MarinStevic/PassVault/README.md

PassVault

Uređaj dizajniran u sklopu diplomskog rada: https://dabar.srce.hr/islandora/object/etfos%3A3328
