MarinStevic/PassVault/BOM/PassVault.xlsx

Qty | Value | Device | Package | Parts | Reference Partno.
1 | 470R | R-US_R0201 | R0201 | R2 | RC0201FR-07470RL
2 | 4.7k | R-US_R0201 | R0201 | R1, R5 | RC0201FR-074K7L
2 | 16p | C-EUC0201 | C0201 | C15, C21 | CC0201JRNPO9BN160
1 | 2.4p | C-EUC0201 | C0201 | C20 | GRM0335C1E2R4CA01D
1 | 3p | C-EUC0201 | C0201 | C18 | GRM0335C1H3R0BA01D
1 | 100p | C-EUC0201 | C0201 | C12 | CC0201JRNPO9BN101
1 | 1n | C-EUC0201 | C0201 | C1 | GRM033R61E102KA01D
8 | 100n | C-EUC0201 | C0201 | C5, C6, C8, C9, C10, C14, C17, C19 | CC0201KRX5R6BB104
1 | 100n | C-EUC0402 | C0402 | C2 | GRM155R71H104ME14D
3 | 1u | C-EUC0201 | C0201 | C7, C11, C13 | CL03A105MQ3CSNC
2 | 1u 10V | C-EUC0402 | C0402 | C3, C4 | CL03A105MP3NSNC
1 | 10u | C-EUC0402 | C0402 | C16 | GRJ155R60J106ME11D
1 | 2nH | L-USL0201 | L0201 | L1 | LQP03TG2N0B02D
1 | 2.2nH | L-USL0201 | L0201 | L2 | SDCL0603Q2N2BT02B03
1 | USB_A_SMT_MALE | USB_A_SMT_MALE | USB-A-SMT-MALE | J2 | U217-041N-4BV81
1 | MOMENTARY-SWITCH-SPST-SMD-12MM | MOMENTARY-SWITCH-SPST-SMD-12MM | TACTILE_SWITCH_SMD_12MM | BOOT | K2-1103SP-E4SW-04
1 | WS2812B3535 | WS2812B3535 | LED3535 | LED1 | WS2812B-Mini
1 | LESD8D3.3CAT5G | LESD8D3.3CAT5G | LESD8D3.3CAT5G | D1 | LESD8D3.3CAT5G
1 | ME6210A33M3GME6210A33M3G | ME6210A33M3GME6210A33M3G | SOT95P280X110-3N | U1 | ME6210A33M3G
1 | W25Q16JVSSIQ | W25Q16JVSSIQ | SOIC127P790X216-8N | U2 | W25Q32JVSSIQ
1 | ESP32-S2QFN54 | ESP32-S2QFN54 | QFN40P700X700X90-57T400N | U3 | ESP32-S2
1 | ABM8W-40.0000MHZ-4-B1U-T3 | ABM8W-40.0000MHZ-4-B1U-T3 | OSCSC320X250X100N | Y1 | CF4040M00012T8188059
