MarinStevic/PassVault/3D Model/PassVault.step

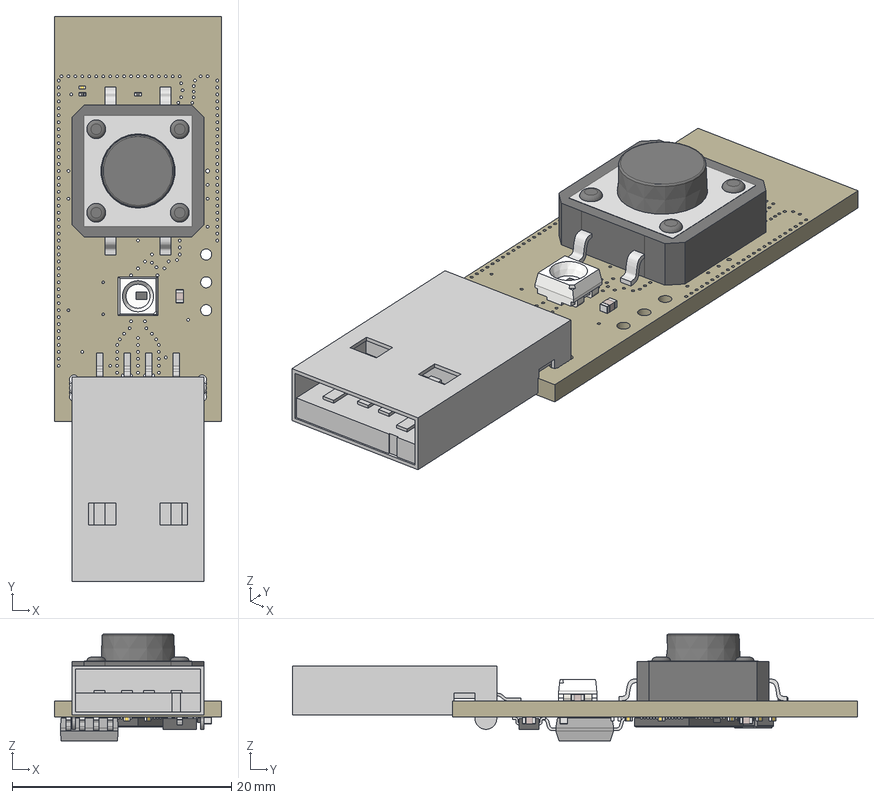
[picture p1: CAD file, 2021-11-04]
3D Model/PassVault.step
15.2 x 51.6 x 9.75 mm
Board
LED3535
QFN40P700X700X90-57T400N
1X03
USB-A-SMT-MALE
TRACE_ANTENNA_2.4GHZ_15.2MM
TACTILE_SWITCH_SMD_12MM
C0201 x 17
C0402 x 4
L0201 x 2
R0201 x 3
OSCSC320X250X100N
LESD8D3.3CAT5G
SOIC127P790X216-8N
SOT95P280X110-3N
