MarinStevic/PassVault/Schematic/PassVault.pdf

# GND100n GND

# GND GND

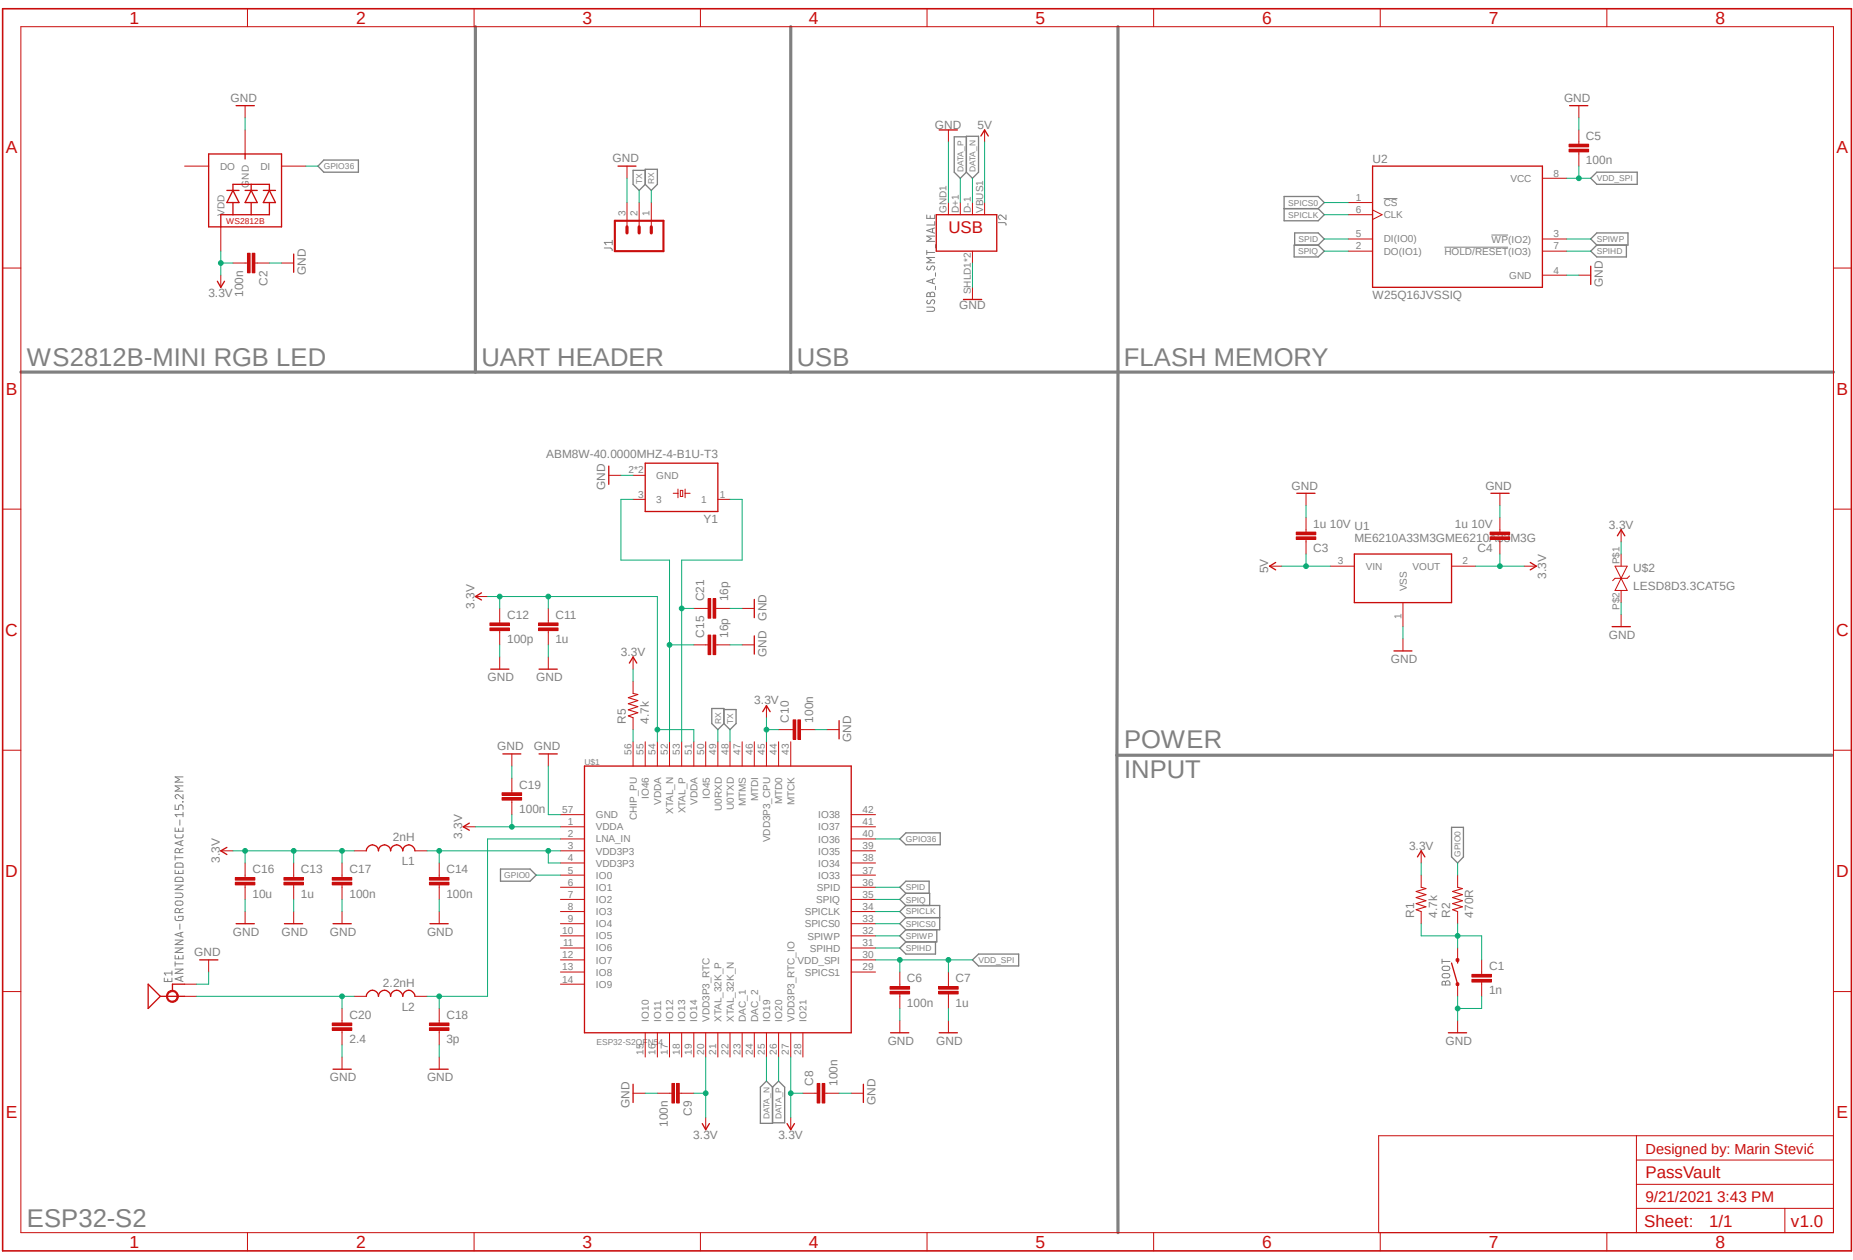
[picture p2: page 1]

WS2812B-MINI RGB LED | GND UART HEADER | GND 5V USB | FLASH MEMORY
