MarinStevic/PassVault/Eagle files/PassVault.brd

## EAGLE design Eagle files/PassVault.brd (2021-11-04)

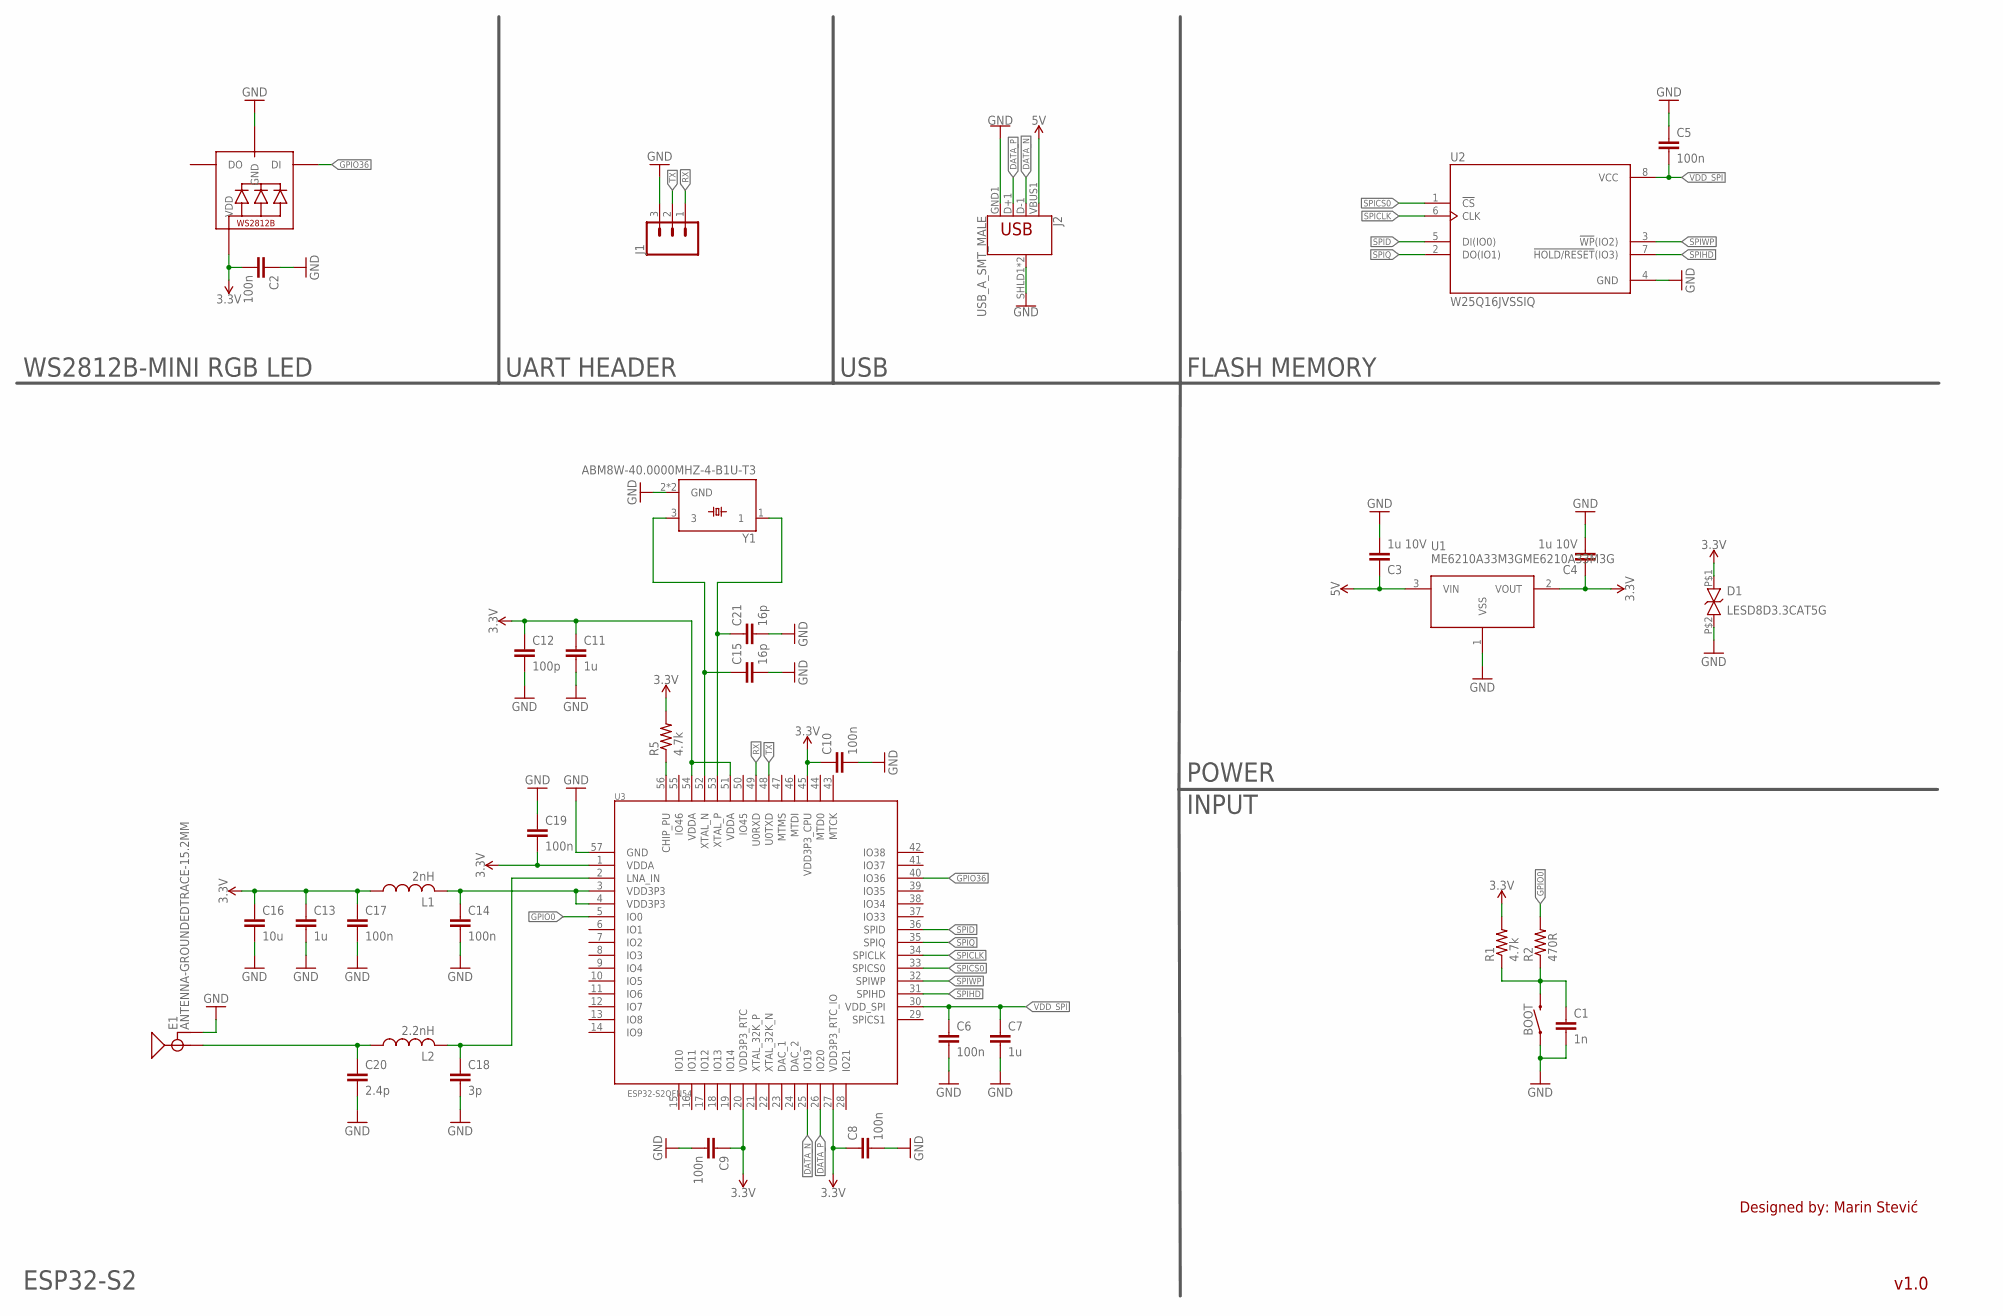
[picture p3: schematic PassVault.sch]

Parts:
BOOT: MOMENTARY-SWITCH-SPST-SMD-12MM; TACTILE_SWITCH_SMD_12MM
C1: 1n; C0201
C2: 100n; C0402
C3, C4: 1u 10V; C0402
C5, C6, C8, C9, C10, C14, C17, C19: 100n; C0201
C7, C11, C13: 1u; C0201
C12: 100p; C0201
C15, C21: 16p; C0201
C16: 10u; C0402
C18: 3p; C0201
C20: 2.4p; C0201
D1: LESD8D3.3CAT5G
E1: ANTENNA-GROUNDEDTRACE-15.2MM; TRACE_ANTENNA_2.4GHZ_15.2MM
J1: CONN_03; 1X03
J2: USB_A_SMT_MALE; USB-A-SMT-MALE
L1: 2nH; L0201
L2: 2.2nH; L0201
LED1: WS2812B3535; LED3535
R1, R5: 4.7k; R0201
R2: 470R; R0201
U1: ME6210A33M3GME6210A33M3G; SOT95P280X110-3N
U2: W25Q16JVSSIQ; SOIC127P790X216-8N
U3: ESP32-S2QFN54; QFN40P700X700X90-57T400N
Y1: ABM8W-40.0000MHZ-4-B1U-T3; OSCSC320X250X100N

Connections:
3.3V: C2.2, C4.1, C8.1, C9.1, C10.1, C11.1, C12.1, C13.1, C16.1, C17.1, C19.2, D1.P$1, L1.1, LED1.1 (VDD), R1.2, R5.2, U1.2 (VOUT), U3.1 (VDDA), U3.20 (VDD3P3_RTC), U3.27 (VDD3P3_RTC_IO), U3.45 (VDD3P3_CPU), U3.51 (VDDA), U3.54 (VDDA)
3.3V1: C20.1, E1.ANT (SIGNAL), L2.1
5V: C3.1, J2.VBUS1 (VBUS), U1.3 (VIN)
DATA_N: J2.D-1 (D-), U3.25 (IO19)
DATA_P: J2.D+1 (D+), U3.26 (IO20)
GND: BOOT.1, C1.2, C2.1, C3.2, C4.2, C5.1, C6.2, C7.2, C8.2, C9.2, C10.2, C11.2, C12.2, C13.2, C14.2, C15.2, C16.2, C17.2, C18.2, C19.1, C20.2, C21.2, D1.P$2, E1.GND, J1.3, J2.GND1 (GND), J2.SHLD1 (SHIELD), J2.SHLD2 (SHIELD), LED1.3 (GND), U1.1 (VSS), U2.4 (GND), U3.57 (GND), Y1.2 (GND), Y1.4 (GND)
GPIO0: R2.2, U3.5 (IO0)
GPIO36: LED1.4 (DI), U3.40 (IO36)
unnamed: R5.1, U3.56 (CHIP_PU)
unnamed: BOOT.3 (2), C1.1, R1.1, R2.1
unnamed: C14.1, L1.2, U3.3 (VDD3P3), U3.4 (VDD3P3)
unnamed: C15.1, U3.52 (XTAL_N), Y1.3
unnamed: C21.1, U3.53 (XTAL_P), Y1.1
unnamed: C18.1, L2.2, U3.2 (LNA_IN)
RX: J1.1, U3.49 (U0RXD)
SPICLK: U2.6 (CLK), U3.34 (SPICLK)
SPICS0: U2.1 (!CS), U3.33 (SPICS0)
SPID: U2.5 (DI(IO0)), U3.36 (SPID)
SPIHD: U2.7 (!HOLD/RESET!(IO3)), U3.31 (SPIHD)
SPIQ: U2.2 (DO(IO1)), U3.35 (SPIQ)
SPIWP: U2.3 (!WP!(IO2)), U3.32 (SPIWP)
TX: J1.2, U3.48 (U0TXD)
VDD_SPI: C5.2, C6.1, C7.1, U2.8 (VCC), U3.30 (VDD_SPI)

Notes on the sheet:
WS2812B-MINI RGB LED
UART HEADER
USB
FLASH MEMORY
POWER
INPUT
ESP32-S2
v1.0
Designed by: Marin Stević

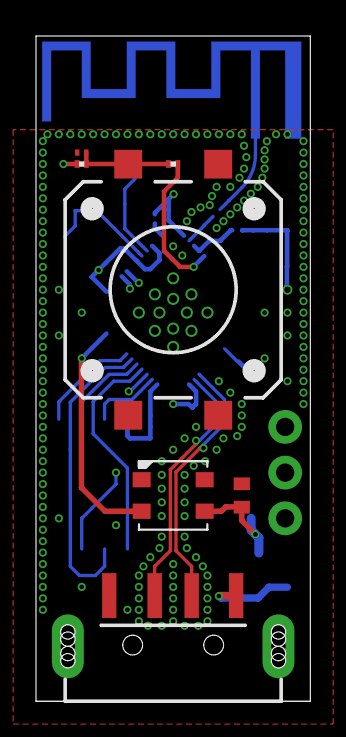
[picture p4: board PassVault.brd from above]

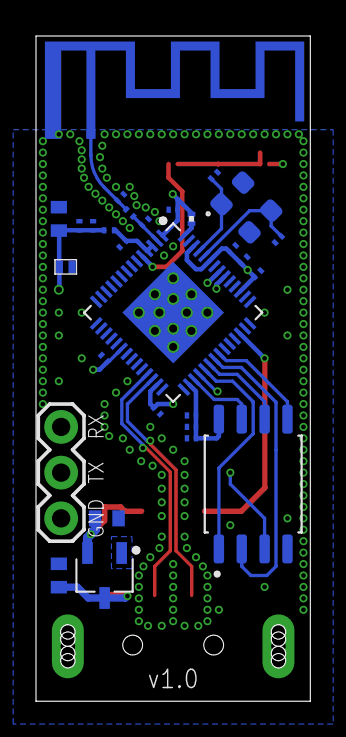
[picture p5: board PassVault.brd from below]

Board: 4 copper layers, 15.2 x 37.0 mm, 36 parts (29 on the bottom side), 23 nets.
