MarinStevic/PassVault/PassVault/private_key.h

#ifndef PRIVATE_KEY_H_
#define PRIVATE_KEY_H_
unsigned char example_key_DER[] = {
  0x30, 0x82, 0x02, 0x5d, 0x02, 0x01, 0x00, 0x02, 0x81, 0x81, 0x00, 0xdd,
  0xfd, 0xc1, 0x90, 0x7f, 0x6c, 0xf7, 0x25, 0x4b, 0xa7, 0x0a, 0xc7, 0x33,
  0x56, 0xb8, 0x85, 0xa3, 0x44, 0xa4, 0x99, 0x33, 0xe2, 0x3c, 0x89, 0xe6,
  0xb2, 0xec, 0x74, 0x06, 0x51, 0x7f, 0xa6, 0x62, 0x4f, 0x48, 0xb5, 0x30,
  0x13, 0xb9, 0xb2, 0x8f, 0x14, 0x87, 0x99, 0xb4, 0xf9, 0xb1, 0x42, 0xcd,
  0xeb, 0x27, 0x17, 0xb4, 0x9a, 0xde, 0xb4, 0x0f, 0x33, 0xef, 0x3d, 0x1b,
  0xd8, 0xec, 0x14, 0xf6, 0x1c, 0x00, 0xdc, 0x2e, 0xcc, 0xd7, 0xcc, 0x2c,
  0x22, 0x02, 0xba, 0xac, 0x3b, 0xc1, 0x99, 0x1b, 0x2a, 0x03, 0x2b, 0x1f,
  0xba, 0x9e, 0x44, 0xdd, 0xad, 0x17, 0xf5, 0x43, 0x82, 0x2f, 0x65, 0x7c,
  0x47, 0x46, 0x11, 0x21, 0x1f, 0xe3, 0x31, 0x8f, 0x2b, 0xc9, 0x6b, 0xde,
  0x1c, 0xc7, 0xfe, 0x69, 0x86, 0xf4, 0x77, 0x44, 0x0f, 0x36, 0x0d, 0x2f,
  0x13, 0x22, 0x86, 0xb3, 0x6e, 0x64, 0xad, 0x02, 0x03, 0x01, 0x00, 0x01,
  0x02, 0x81, 0x81, 0x00, 0x93, 0xa6, 0xa2, 0x46, 0x3f, 0xda, 0xf4, 0x0f,
  0x64, 0x60, 0x38, 0x75, 0x02, 0x1a, 0x9e, 0x24, 0x94, 0xd1, 0xa5, 0x41,
  0x19, 0x17, 0x52, 0xf8, 0xcd, 0xef, 0x18, 0x02, 0x9b, 0xe9, 0x3d, 0x24,
  0x27, 0xa3, 0x60, 0x52, 0xd3, 0x25, 0x6b, 0x8f, 0xee, 0x46, 0xd3, 0x62,
  0x52, 0xd2, 0xf9, 0x29, 0xdb, 0xd8, 0x9a, 0x69, 0xd4, 0x00, 0x66, 0x3c,
  0x11, 0x18, 0x93, 0xf9, 0x6b, 0x3a, 0x3e, 0xda, 0xfd, 0x25, 0x91, 0x5e,
  0x40, 0x05, 0xba, 0x77, 0xa3, 0xab, 0x4f, 0x83, 0xe8, 0xb7, 0x4f, 0x49,
  0x53, 0x57, 0x7a, 0xc4, 0x8f, 0xe2, 0x31, 0x3c, 0xc7, 0x02, 0xdf, 0xd6,
  0x45, 0xa6, 0x0f, 0xbf, 0x52, 0xef, 0x98, 0x80, 0x59, 0x8b, 0x94, 0x1d,
  0x19, 0x2e, 0xbd, 0x9c, 0xe6, 0x44, 0x4f, 0x0a, 0xe7, 0x48, 0x04, 0x70,
  0xf5, 0x1d, 0xa6, 0x93, 0x2b, 0x6a, 0x64, 0xea, 0x32, 0xa9, 0x83, 0xe9,
  0x02, 0x41, 0x00, 0xf2, 0x3c, 0x16, 0x9e, 0x0c, 0xaf, 0x7e, 0x02, 0x30,
  0xf6, 0x3f, 0xdb, 0xc8, 0x06, 0x93, 0x7a, 0x54, 0x79, 0x69, 0x93, 0xab,
  0xaf, 0xa5, 0xb6, 0xdf, 0x06, 0x25, 0x6b, 0x72, 0xea, 0x39, 0xec, 0x5a,
  0x97, 0x90, 0x04, 0xc9, 0xc5, 0xa6, 0x8c, 0x9d, 0x5f, 0x23, 0xdf, 0xec,
  0x7e, 0xd1, 0x3c, 0x3d, 0xb2, 0xe0, 0xa8, 0x65, 0x41, 0xaf, 0x4a, 0x96,
  0x2a, 0x07, 0xe0, 0xb0, 0x3d, 0x5b, 0x0b, 0x02, 0x41, 0x00, 0xea, 0x9b,
  0x2c, 0xec, 0xbd, 0x04, 0xc0, 0x8b, 0x8a, 0x22, 0xa9, 0xba, 0x3b, 0x3c,
  0xaf, 0x8b, 0x29, 0xad, 0xc7, 0xc3, 0xa0, 0x1e, 0xd6, 0x97, 0x81, 0xe3,
  0xe1, 0x34, 0xdf, 0x43, 0x1c, 0x54, 0xf9, 0x55, 0x87, 0xb3, 0x15, 0xa2,
  0x94, 0xd3, 0xf1, 0x93, 0xc1, 0xcc, 0x25, 0xaa, 0xda, 0x65, 0x9f, 0xc1,
  0x13, 0x03, 0xf0, 0xc5, 0x36, 0x51, 0xeb, 0x76, 0x73, 0x86, 0x8c, 0x44,
  0x52, 0x27, 0x02, 0x40, 0x69, 0x62, 0x7a, 0xf4, 0x87, 0xd0, 0x51, 0xa1,
  0xe2, 0x6b, 0x3f, 0x9c, 0xfe, 0x88, 0xdd, 0xe0, 0x7a, 0x9f, 0xd7, 0xae,
  0xc7, 0x22, 0xc3, 0x95, 0xab, 0xb1, 0xa0, 0xd5, 0xfe, 0x48, 0xa8, 0xaa,
  0x8b, 0x3f, 0x25, 0x08, 0xf0, 0x3f, 0x6d, 0x15, 0xff, 0xe1, 0x44, 0x5a,
  0x47, 0x29, 0x65, 0x1e, 0x30, 0x39, 0x82, 0x43, 0xc0, 0xc9, 0xb2, 0xd9,
  0x60, 0x3b, 0x28, 0xf2, 0x37, 0xba, 0x79, 0xc1, 0x02, 0x40, 0x3d, 0xa8,
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
};
unsigned int example_key_DER_len = 609;
#endif
